gurkandyilmaz/EE463-Hardware_Project/README.md

# EE463-Hardware_Project
2018-2019 EE463 Hardware Project
